shenguangmu/complete_project_source/skill/pitfalls/README.md

# 踩坑清单 —— 工具静默失败的定位方法

> **为什么这份清单值得读**：这些坑的共同特征是
> **工具不报错，或者报错位置离真正原因很远**。
> 每一条都给出**验证命令** —— 不靠推理，靠输出。

## 怎么用

按**现象**查，不按原因查。你手里只有现象。

| 现象 | 去哪条 |
|---|---|
| 综合/实现全过，但 DRC 报一堆莫名其妙的端口名 | **P1** |
| 加了"失败重试"，日志显示重试了但同一秒返回 | **P2** |
| 脚本跑到最后突然 `No open design`，产物缺失 | **P3** |
| OOC 综合日志里出现 `Failed to create directory 'C'` | **P4** |
| 改了源码，报告里的旧数字还在，没人发现 | **P5** |
| 测试脚本打了 `[FAIL]` 却报 `PASSED` | **P6** |
| 渲染/导出漏了一种块类型，内容静默消失 | **P7** |
| 综合通过但上板数据不对 | 见 `docs/board-bringup-guide.md` 的分级验证 |
| HLS 相关（pragma 被丢、csim 假成功…） | 见附录索引 |

---

## P1 · 顶层被静默设成子模块，整条流水线未进综合

**现象**

```
[DRC NSTD-1] 67 out of 67 logical ports use IOSTANDARD 'DEFAULT'
问题端口: cam_data[7:0], frame_cnt[15:0], aclk, pclk ...
```

端口名**看着像某个子模块的**，不是你的顶层。
日志里是 `Command: synth_design -top <子模块名>`。

**根因**

Block Design 生成时会**重新生成 wrapper**，把它从工程文件表里挤掉。
Vivado 只好在剩余模块里**自动挑一个当顶层** —— 挑中了某个 RTL 子模块。

**为什么难查**：**全流程静默通过**。综合、实现、出比特流都不报错。

**对策**

**必须回读断言**，不能靠"没报错就当对了"：

```tcl
set top_now [get_property top [current_fileset]]
if {$top_now ne "${BD_NAME}_wrapper"} {
    error "顶层设置失败：期望 ${BD_NAME}_wrapper，实际 '$top_now'"
}
if {[llength [get_files -quiet *${BD_NAME}_wrapper.v]] == 0} {
    error "wrapper 未登记进工程文件表"
}
```

**验证**

```bash
grep "Command: synth_design" <project>.runs/synth_1/runme.log
# 必须是你的顶层名。是子模块名 → 中招了
```

---

## P2 · `launch_runs` 对**已失败**的 run 不做任何事 → 重试是假的

**现象**

给 run 加了"失败就重跑"的重试，日志显示重试了，但**同一秒就返回**：

```
>>> synth_1 进度 0% —— 第 1 次未完成
>>> 重试...
[21:38:34] Waiting for synth_1 to finish...
[21:38:34] synth_1 finished        ← 同一秒返回，根本没跑
```

**根因**

`launch_runs` 认为那个 run "已经跑过了"（只是结果是失败），**于是什么都不做**。
光靠"再 launch 一次"是**假重试**。

**对策**

重试前先 `reset_run`（**已完成的子 run 不受影响**，只有失败的需要重跑）：

```tcl
if {$attempt > 1} { catch {reset_run -quiet $run_name} }
catch {launch_runs $run_name -jobs 8 {*}$launch_args}
catch {wait_on_run $run_name}
```

**⚠ 配套坑**：找失败子 run **不能用** `get_runs "${run_name}_*"` ——
run 叫 `synth_1`，子 run 却叫 `bd_video_dma_in_0_synth_1`，**glob 匹配不到**，
那段诊断会**静默失效**（你以为在报错，其实一行没输出）：

```tcl
# 错：匹配不到任何东西
foreach sr [get_runs -quiet "${run_name}_*"] { ... }

# 对：遍历全部，按后缀筛，排除父 run
foreach sr [get_runs] {
    set sn [get_property NAME $sr]
    if {$sn eq $run_name} { continue }
    if {[string match "*_$run_name" $sn] && [get_property PROGRESS $sr] ne "100%"} { ... }
}
```

> **这条的教训**：桩函数能验证"重试被调用了"，但**验证不了
> `launch_runs` 的真实语义**。控制流对 ≠ 行为对。

---

## P3 · `get_timing_paths` 需要**已打开的设计**

**现象**

脚本跑到 "实现完成" 后突然中断：

```
>>> 实现完成
ERROR: [Common 17-53] User Exception: No open design.
```

**后果**：后面的产物导出**根本没执行到**。
而 `write_bitstream completed successfully` 就在日志里 —— **容易误以为"都成功了"**。

**根因**

`get_timing_paths` 写在 `open_run impl_1` **之前**。

**对策**

```tcl
open_run impl_1        # ← 必须在前面

# 时序查询本身也加 catch —— 它只是**报告**，不该有中断整个流程的能力
if {[catch {
    set wns [get_property SLACK [get_timing_paths -delay_type max]]
    puts ">>> WNS = $wns ns"
} err]} {
    puts "WARN: 取时序失败（不影响产物）: $err"
}
```

**验证**

判据不是"脚本没报错"，而是**产物在不在**：

```bash
ls -la <project>/<name>.xsa <project>/utilization.rpt
```

> **这条的教训**：脚本"跑到最后一行"和"所有产物都生成了"是**两回事**。

---

## P4 · `Failed to create directory 'C'` —— 产物无害，**流程致命**

**现象**

OOC 综合日志里出现（**每次打中的 run 都不一样**，是随机的）：

```
ERROR: [Common 17-354] Could not open 'C' for writing.
ERROR: [Common 17-1257] Failed to create directory 'C'.
```

看起来像环境变量问题（某个变量为空、被展开成裸盘符 `C`），**但不是**。

**根因**

一次性启动 16–22 个 OOC 综合，每个 Vivado 实例都要建一批临时目录 ——
**并发建目录竞争的瞬时失败**。重跑必然成功
（中招的 run 自己的 `.dcp` 其实照样生成了）。

**已排除**（这些查过都不是原因）：
- `TEMP` / `TMP` 正常
- 无空环境变量会被展开成裸盘符
- 脚本里没有任何地方传过 `"C"`

**⚠ 为什么不能当噪声忽略**

Vivado 会把这个瞬时失败**判定成 run 失败**：

```
ERROR: [Vivado 12-13638] Failed runs(s) : '<run 名>'
ERROR: [Common 17-39] 'wait_on_runs' failed due to earlier errors.
```

于是 `wait_on_run` **直接抛错返回**，脚本中断 —— **后面的产物根本导不出来**。

**对策**：带 `reset_run` 的重试（见 **P2**）。

**验证**

```bash
grep -c "17-1257\|17-354" <run>/runme.log   # 出现了几条
grep -c "^ERROR" <impl>/runme.log            # 但整体 ERROR 应为 0
```

---

## P5 · 报告里的数字比源码旧 —— 改了代码，没人发现

**现象**：你改完源码、跑完综合、去读报告里的资源数，
**读到的是上一次运行的**。报告不会自己告诉你它过期了。

**本项目实际发生的**：
做 DSP 对照实验时来回改了四次源码，最后一次（展开版，86 DSP）跑完
就去写文档了；等回头核对数字时，`csynth.rpt` 里躺着的还是**85 实验版**的数，
而源码已经 `git checkout` 回基线了。
**如果当时没顺手多跑一次，写进报告的就是一组对不上源码的数字。**

**为什么危险**：这类错误的后果和 P2 一样 ——
**看起来一切正常**。数字是"真的"（确实是工具产出的），
只是**不是当前源码的**。csim 会拦住代码错误，**谁也拦不住这个**。

**验证命令**：

```bash
# ① 比时间戳：报告比源码旧，就说明报告过期了
ls -l --time-style=+%m-%d_%H:%M src_hls/gesture_preproc.cpp \
      gesture_comp/solution1/syn/report/csynth.rpt
#         源码必须比报告旧（或同一时刻）

# ② 比 git 状态：源码有未提交改动，报告必然对不上
git status --short src_hls/
```

**根治**：**不要在"源代码有未提交改动"的状态下引用报告数字**。
要么先 `git stash`/`checkout` 到目标状态重跑，要么在提交后重跑一次。

> **更一般的教训**：**引用一个数字前，先确认它属于哪次运行。**
> 这和"引用前先确认它属于哪个模块"（`WNS +0.265` 的教训）是同一类问题 ——
> 数字的**出处**和数字本身一样重要。

---

## P6 · 测试脚本打了 `[FAIL]` 却报 `PASSED`

**现象**：自检脚本明明打印了一行 `[FAIL] ...`，
最后汇总却是 `*** TEST PASSED ***`，退出码 0。CI 于是放行。

**根因**：失败路径**没有走计数器**。典型写法：

```python
def step2():
    try:
        from pynq import allocate
    except ImportError:
        print("    [FAIL] 连 pynq 都 import 不了")
        return False          # ← 打印了，但 _failed 没加一
```

主流程只在 `_failed` 里统计，而这个早退分支跳过了它 ——
**"报错"和"记账"是两条独立的路径，只做了前者。**

**本项目实际发生的**：写 `host/bringup_check.py` 时第一版就是这样，
在 PC 上试跑 `--step 2` 才抓到（无板环境必然 import 失败，正好走这条分支）。
**如果没有"无板也能跑一遍"这一步，这个 bug 会一直留到上板那天**，
而且表现是"明明失败却告诉你成功"—— 比直接崩掉危险得多。

**对策**：**所有失败路径都走同一个记账函数**，不允许裸 `return False`：

```python
def _fail():
    global _failed
    _failed += 1
    return False

# 所有早退分支统一写成
    print("    [FAIL] ...")
    return _fail()
```

**验证命令**（这条才是关键 —— 光看代码看不出来）：

```bash
# 故意制造一个必然失败的场景，看汇总结论对不对
python host/bringup_check.py --step 2   # 在无 pynq 的 PC 上跑
# 期望：打印 FAILED，且 echo $? == 1
```

> **一般化的教训**：**测试脚本本身也要被测。**
> 而且最省事的测法是**让它跑一个必然失败的场景** ——
> 正常路径谁都会测，**失败路径才是没人走的那条**。

---

## P7 · 渲染/导出漏了一种块类型，内容**静默消失**

**现象**：源文件里明明有的内容，生成出来的 Word / PDF / 静态站点里**没有**。
而且**不报任何错** —— 生成器照常打印"已完成"。

**根因**：生成器把源文件解析成若干**块类型**，
然后按类型分别渲染。**新加了一种块类型，却只在一个地方处理了它。**

**本项目实际发生的**（2026-09-19）：

给上板手册加"在哪跑"标记 `【终端：PC · Git Bash】`，
解析器产出了 `terminal` 块类型，但渲染器里那段处理写在了
`elif t == 'para'` 分支里 —— 而 `terminal` 是**独立类型**，走不到那一支。

结果：**17 个标记一个都没渲染出来，全被丢掉**。

更隐蔽的是**误导性的"部分成功"**：手册引言的代码块里正好有 4 行
**示例文字**也是 `【终端：…】` 的形状，它们作为代码内容被正常渲染了 ——
于是 grep 一下能搜到 4 个，看着像"功能是好的，只是少了几个"。

**怎么抓到的**：不是靠眼看，是靠一条**内容零丢失**的自动检查 ——
把源文件和产出的所有文字都摊平，反向核对每一行还在不在。
`scripts/test_manual.py` 第 [3] 项就是这个。

**对策**：

1. **加块类型时，把"渲染分支"和"测试的摊平函数"一起改。**
   本项目就被这个坑咬了两次：`iter_text()` 漏了 `terminal` 分支
   （导致测试误报"内容丢失"），`render()` 也漏了（真丢内容）。
2. **写一条"零丢失"检查**，别靠"生成成功"当判据。
   它抓的是**所有**静默丢失，不只是你想到的那一种。
3. ⚠ **两处渲染路径都要维护**：本项目有"主体渲染"和"引用块渲染"
   两条路径，只改一条 → 表现为"某些位置的标记不显示"，同样不报错。

> **一般化**：**生成器/编译器/导出器最危险的失败模式是"不报错、只少东西"。**
> 编译器至少有类型系统兜底，而**文档生成器什么都没有** ——
> 它丢一段和你故意删一段，产出是一样的。

---

## 附录：更完整的清单

本目录只列了**"工具流程全过、只有上板才暴露"**这一类中最典型的 7 条。
更完整的 15 条（HLS 接口/pragma、Vitis 命令行、BD/Tcl、Zynq 协同、环境噪声）
见项目仓库 `vivado/README.md` 的「踩过的 19 个坑」一节，
其中前 15 条按 A–E 五类组织。

**判断一条报错要不要管的通用方法**：

```bash
# 只看这两种级别
grep -E "ERROR|CRITICAL WARNING" <runme.log>
# 数一下
grep -c "^ERROR" <runme.log>
```

> 一个 33 KB 的 `vivado.log` 里有 **111 条 WARNING 但 0 条 ERROR** 是**正常**的。
> 别因为刷屏就以为工程有问题 —— 但也别反过来，把 ERROR 当噪声。
> **P4 就是后者**：它对产物无害，但对流程致命。
