shenguangmu/complete_project_source/location.png

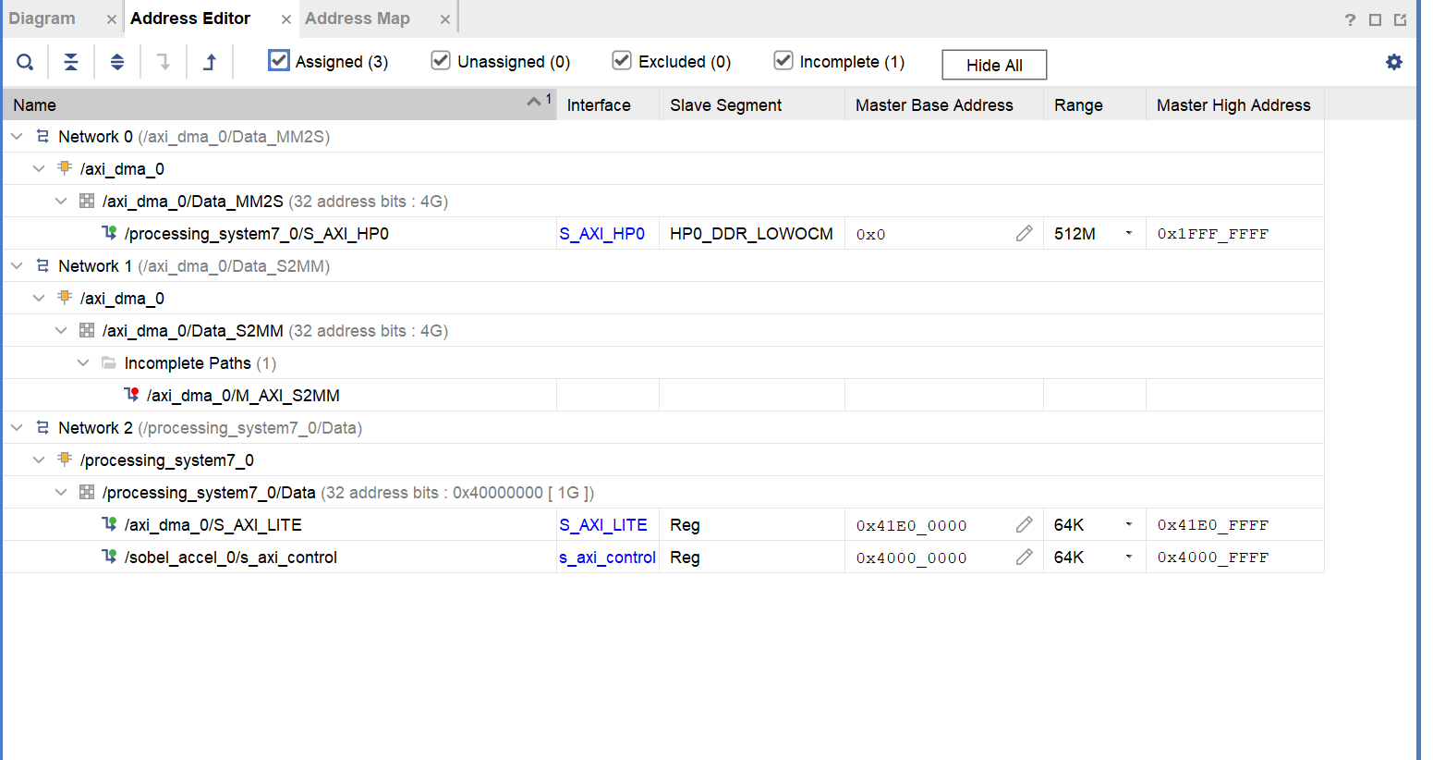
location.png
