shenguangmu/complete_project_source/docs/board-bringup-guide.md

# 上板测试指南 — 手势识别系统

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

---

### 本文用到的四个环境（**每段代码前都标了在哪跑**）

上板这件事最容易卡住的地方，不是命令本身，而是**不知道该在哪儿敲**。
所以本文在**每段代码前面**都加了一个标记：

```
【终端：PC · Git Bash】              ← 在你的开发机上
【终端：PYNQ · Jupyter 或串口】       ← 在板子上的 Linux 里
【终端：串口 · MobaXterm】            ← 串口终端（看启动日志用）
【终端：仪器 · 万用表】               ← 手持仪器，不是电脑
```

四个环境分别是：

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

> ⚠ **PC 和 PYNQ 上都有 Python，但装的东西完全不同**：
> PC 上**没有 `pynq` 模块**（`import pynq` 会失败，这是正常的）；
> PYNQ 上**没有 Vivado**。
> 在错的那一侧跑，报错是 `ModuleNotFoundError` 或 `command not found` ——
> 看着像环境坏了，其实只是跑错了地方。**这就是这些标记存在的理由。**

---

## 0. 先说结论：硬件已定，只剩 1 个阻塞

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

---

## 1. 前置条件（上电前必须确认的事项）

### 1.1 ~~B1~~ — 摄像头模块（**已定：PMOD-CAMERA v1.0** ✅）

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

**两个连接器的信号分配**：

```
J2 → Pmod A（6 根）： XMCLK / DVP_VSYNC / I2C_SDA / DVP_PCLK / DVP_HREF / I2C_SCL
                      （另有 2 个 NC 脚：ja[3]=Y17, ja[7]=W19）
J3 → Pmod B（8 根）： D6 D4 D2 D0 D7 D5 D3 D1  ← 数据线是**交错**的，不是顺序
```

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

---

### 1.2 ~~B2~~ — `io_xclk` 约束（**不缺** ✅）

> ## ⚠⚠ 更正：本指南初版这一节是错的
>
> **初版写的是"`io_xclk` 没有任何引脚约束，线是悬空的"—— 那是错的。**
>
> 实际约束在 `video_io.xdc:183`：
> ```tcl
> set_property -dict { PACKAGE_PIN Y18 IOSTANDARD LVCMOS33 } [get_ports io_xclk]
> ```
> **核实方式**（从实现产物回读，不是看文档）：
> ```
> $ grep io_xclk bd_video_wrapper_io_placed.rpt
> | Y18 | io_xclk | High Range | IO_L17P_T2_34 | OUTPUT | LVCMOS33 | ... | FIXED | ...
> ```
> `Constraint = FIXED` —— 约束确实生效了。
>
> **初版为什么错**：我把"某份规格表里没列 io_xclk"当成了"约束文件里没有它"，
> **没有做任何验证就写进了文档，还把它列成阻塞项**。
> 这正是本指南开头警告的那类错误 —— 只不过这次犯的是我自己。
>
> **教训**：判断"某个约束在不在"，要 `grep` 约束文件或回读实现报告，
> **不能凭印象或凭别的文档**。

既然用 PMOD-CAMERA（无晶振），`io_xclk` **必须保留**：

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

---

### 1.3 B3 — 寄存器表必须换成真的

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

`rtl/ov5640_regs.v` 曾经是**占位表**（`rtl/README.md` 当时写的：
"表里的 8 条寄存器值是猜测，**不足以让 OV5640 出图**"）。

TB 验的是**接口行为**（拼接顺序、位宽、边界），**不验内容** —— 所以 11/11 PASSED 不代表能用。

**症状**：万用表/示波器测得 `io_xclk` 有 24 MHz，但 **`io_pclk` 一直没波形**。
看到这个现象先查寄存器表，别去查 RTL。

**来源**：正点原子例程里的 `ov5640cfg.h`（或其 Linux 驱动 `ov5640.c`）。
需要的是「RGB565 / 640×480 / 30fps」那套配置。

> ⚠ **别只抄前几条**。OV5640 的配置是**有顺序依赖**的，
> 常见的是 `0x3103` 软复位 → `0x3008` 软复位 → 系统时钟 → 时序 →
> 输出格式 → 分辨率 → 才到具体画质寄存器。抄漏顺序会静默不出图。

---

### 1.4 ~~B4~~ — DDR 参数（**已修复并验证** ✅）

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

2026-09-17 已在 `bd_video.tcl` 补上三条并加了回读断言：

```tcl
CONFIG.PCW_UIPARAM_DDR_PARTNO    {MT41K256M16 RE-125}
CONFIG.PCW_UIPARAM_DDR_BUS_WIDTH {32 Bit}
CONFIG.PCW_UIPARAM_DDR_FREQ_MHZ  {533.333}
```

**2026-09-17 21:53 已重跑验证** ✅ —— 脚本输出：

```
>>> DDR 断言通过 (MT41K256M16 RE-125)
```

产物已更新（比特流 + XSA 里都是正确配置）。**这一条不再是阻塞项。**

> 将来若重建工程，判定标准仍然是日志里出现 `>>> DDR 断言通过 (MT41K256M16 RE-125)`。
> **没有这一行就是没生效**，别继续。

---

## 2. 不接电的安全检查

### 2.1 短路检查

万用表**电阻档（或蜂鸣档）**，测 **3V3 对 GND**：

| 读数 | 含义 |
|---|---|
| 呜一声 / < 10 Ω | **短路，绝对不要上电** |
| 几百 Ω 以上 / 逐渐上升 | 正常（电容充电） |

对**摄像头模块**单独测一次，再对**插上之后的板子**测一次。

### 2.2 引脚万用表复核（**烧板风险，不能跳**）

**【未验证】** XDC 的引脚映射是推理的，没实测过。

**只用量电平和通断，不用示波器，也不需要上电**：
【终端：仪器 · 万用表（通断档）】

```
① 万用表 → 通断档
② 表笔黑端接 PYNQ-Z2 的 GND（挑一个板上标了 GND 的排针）
③ 表笔红端逐个点 Pmod A 的 8 个物理针
④ 通的那个就是 GND 列 —— 记下来
⑤ 同样方法找 3V3（接 3.3V 排针）
⑥ 对照 video_io.xdc 末尾的预期表，核对 GND/3V3 是否落在同一列
```

**判定**：如果 GND/3V3 的位置和 `video_io.xdc` 里推的不一致，
**立刻停止，回来改 XDC**，不要"先插上试试"。

> 这一步花 5 分钟，省掉一块板子。

---

## 3. 上电与 PS 侧验证（**先不加载比特流**）

### 3.1 上电顺序
【终端：硬件 · 断电状态下插线，最后才上电】

```
① 插好 SD 卡（PYNQ 镜像，v3.0.1）
② 接串口线（Micro USB，板上标 UART）
③ 打开串口终端（115200 8N1）
④ 最后插 12V 电源
```

**串口终端选哪个** —— 推荐 **MobaXterm（家庭版，免费）**：

| 工具 | 评价 |
|---|---|
| **MobaXterm Home Edition** ✅ **首选** | **串口 + SSH + SFTP 三合一**，而且免费、有免安装便携版。<br>本项目后面要做的三件事它一个顶三个：<br>· **串口**看 PYNQ 启动日志（`Session → Serial`，选 COM 口 + 115200）<br>· **SSH** 登板子跑命令（串口只能看，敲长命令不方便）<br>· **SFTP 拖拽**传 `.bit` / `.hwh`（省掉记 `scp` 命令） |
| PuTTY | 够用且极小，但**只有串口/SSH，没有文件传输** ——<br>传 `.bit` 还得另找 WinSCP。只当串口终端可以 |
| `tio` / `picocom` | Linux/macOS 上的命令行串口工具，简洁可靠。<br>本机是 Windows，用不上 |
| 各类"串口助手"小工具 | ⚠ 只收发热门波特率的能用，但**看不到 Linux 启动全过程的滚屏**，<br>排查"卡在 Loading kernel"时很吃亏 |

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

### 3.2 光一个指示灯就能砍掉一半问题

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

> 这一步就能验证 B4。**DDR 错了，Linux 根本起不来。**

### 3.3 进 PYNQ
【终端：串口 · MobaXterm（或 PuTTY）· 115200 8N1】

```bash
# 串口里
login: xilinx
password: xilinx

# 看网口 IP（PC 与板子同网段）
ifconfig
```

浏览器开 `http://<板子IP>:9090` → Jupyter。或者直接用串口跑 Python。

---

## 4. 加载 overlay

### 4.0 先把两个文件弄出来（**XSA 里就有，不用重新跑**）

PYNQ 要的是 **`.bit` + `.hwh` 两个文件**，它们**都在仓库里的 `gesture_system.xsa` 中** ——
`.xsa` 本质是个 zip，直接解压即可，**不需要重跑综合**：
【终端：PC · Git Bash】

```bash
# 在 PC 上，仓库根目录
cd vivado/gesture_system
unzip -o gesture_system.xsa -d /tmp/xsa_extract

# 看看里面有什么
unzip -l gesture_system.xsa | grep -E "\.bit|\.hwh"
#   bd_video.hwh            744,025 B
#   gesture_system.bit    4,045,692 B     ← 与 build-report 记录的字节数一致，可据此核对
```

> ⚠ **`.hwh` 在 xsa 里叫 `bd_video.hwh`，但必须改名成 `gesture_system.hwh`** ——
> PYNQ 靠**同名**配对找 IP 表：`gesture_system.bit` ⟷ `gesture_system.hwh`。
> 名字不一致时 PYNQ 不会报"找不到 hwh"，而是**只认出 `default` 一个 IP**，
> 然后你在 `ip_dict` 里一个我们的 IP 都看不到 —— 很容易误判成 overlay 有问题。
【终端：PC · Git Bash】

```bash
# 传到板子（改成同名同目录）
scp gesture_system.bit  xilinx@<板子IP>:/home/xilinx/
scp /tmp/xsa_extract/bd_video.hwh xilinx@<板子IP>:/home/xilinx/gesture_system.hwh
```

**核对拿对了没有**：

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

**两个文件必须同名同目录**（PYNQ 靠配对的 `.hwh` 解析 IP 表）。
【终端：PYNQ · Jupyter（浏览器 :9090）或串口】

```python
from pynq import Overlay
ol = Overlay("/home/xilinx/gesture_system.bit")

# ⚠ 先看它到底认出了什么，别猜
print(sorted(ol.ip_dict.keys()))
```

**期望看到**（**【已核实】** 来自 `bd_video.hwh`）：

```
vdma, v_tc, dma_in, dma_out, gesture_preproc_0
```

**立刻记下地址**（后面每一步都要用）：

```python
for n in ["vdma", "v_tc", "dma_in", "dma_out", "gesture_preproc_0"]:
    ip = ol.ip_dict.get(n)
    print(f"{n:20s} {ip}")
```

**【已核实】** `.hwh` 里的地址是这个（**不是** `docs/architecture-contract.md` §2.14 写的 `0x4300_0000`/`0x43C0_0000`，那是原 Sobel 工程的残留）：

| IP | BASE |
|---|---|
| `gesture_preproc_0` | `0x4000_0000` |
| `dma_in` | `0x41E0_0000` |
| `dma_out` | `0x41E1_0000` |
| `v_tc` | `0x44A0_0000` |
| `vdma` | `0x44A1_0000` |

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

**版本警告**：PYNQ 镜像与 Vivado 2025.2 的兼容性**【未验证】**。
报版本错时：

```python
ol = Overlay("gesture_system.bit", ignore_version=True)
```

---

## 5. 验证顺序（**这是全文最重要的一节**）

按顺序走。**每一步失败就停下**，不要跳过去试下一步 ——
后面所有现象都会被前面没验证的环节污染。

```
① 加载 overlay，ip_dict 认全           → 本文 §4
② DDR 能分配 buffer，读写一致           → 本文 §5.1      ← 不需要摄像头
③ 只跑预处理链（不碰摄像头）            → 本文 §5.2      ← 不需要摄像头
④ io_xclk 有 24 MHz                    → 本文 §5.3
⑤ io_scl 有脉冲（SCCB 在跑）            → 本文 §5.3
⑥ io_pclk 有波形（摄像头配置成功）      → 本文 §5.3
⑦ io_href / io_vsync 有脉冲             → 本文 §5.3
⑧ 数据线 io_d 不是恒 0                  → 本文 §5.3
⑨ VDMA 能抓到帧                        → 本文 §5.4   ← 依赖 ⑥⑦⑧
⑩ 全链路：摄像头 → 96×96               → 本文 §5.5   ← 依赖 ⑨+③
```

**②③ 不需要摄像头**，所以**摄像头还没到货也能先做掉** —— 现在就可以做。

> ### ✅ ②③ 已脚本化：`host/bringup_check.py`
>
> 上面 ②③ 两步的代码**不用手敲**了 —— 已做成可直接跑的脚本：
>
> ```bash
> python3 host/bringup_check.py            # 跑 ②③
> python3 host/bringup_check.py --step 2   # 只跑 DDR 自检
> python3 host/bringup_check.py --json r.json   # 结果落盘（报告用）
> ```
>
> 判定：`*** BRINGUP CHECK PASSED ***`。
> 它会在每一步给出**针对性的排查提示**（比如输出全黑时列出三个常见原因）。
>
> ⚠ **④~⑧ 需要示波器/逻辑分析仪，脚本不做** ——
> 那些是模拟信号的逐级排查，没法自动化。
> 但 ②③ 脚本化之后，**摄像头插上时只剩一条线要查**。

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

| 写在哪 | 指的是 |
|---|---|
| §1.1 表格「出处」列 | `hardware-checklist.md` 第三章、`architecture-contract.md` 第二章 |
| §4 表格上方的注 | `architecture-contract.md` §2.14（那里写的地址**已过时**，勿用） |
| §4 引用契约 | `architecture-contract.md` §3.1 |
| §5.2 启动顺序 | `docs/architecture-contract.md` §4.3 |
| §5.3 上方 | `docs/hardware-checklist.md` 第二章（工具采购建议） |
| §6.1 表格「出处」列 | skill `09-pitfalls.md` 的 C1/C3/E1、`gui-reproduction-guide.md` §2.9 |

---

### 5.1 DDR 与 buffer 基本自检
【终端：PYNQ · Jupyter 或串口】

```python
from pynq import allocate
import numpy as np

buf = allocate(shape=(9216,), dtype=np.uint8)
buf[:] = np.arange(9216, dtype=np.uint8)
print("读回一致:", np.array_equal(buf, np.arange(9216, dtype=np.uint8)))
print("物理地址:", hex(buf.physical_address))
```

**判定**：打印 `True` 且有非 0 物理地址。
**失败** → 回 §1.4，DDR 参数不对。

---

### 5.2 第一步真正的功能验证：**只跑预处理链**（不需要摄像头）

这是**当前最应该先做的事** —— 它把摄像头这个最大的不确定性排除在外。

数据流：

```
DDR(输入 640×480 RGB565) ─► dma_in(MM2S) ─► gesture_preproc ─► dma_out(S2MM) ─► DDR(96×96)
```

**⚠ 启动顺序不能反**（`docs/architecture-contract.md` §4.3）：

```
① 填输入数据 + flush cache
② 先武装 dma_out（S2MM）   ← 必须先，否则预处理输出的第一拍没有接收方
③ 再启动 dma_in（MM2S）
④ 最后 ap_start
⑤ 轮询 ap_done
⑥ invalidate cache，读结果
```
【终端：PYNQ · Jupyter 或串口】

```python
inbuf  = allocate(shape=(640*480,), dtype=np.uint16)   # RGB565
outbuf = allocate(shape=(9216,), dtype=np.uint8)       # 96×96

# 用 host/dump_frame.py 造的测试图当输入，或先填个已知图案
# ... 填 inbuf ...

inbuf.flush()
outbuf.flush()

# ⚠ 顺序：先 S2MM，再 MM2S
dma_out.recvchannel.transfer(outbuf)
dma_in.sendchannel.transfer(inbuf)

gp = ol.gesture_preproc_0
gp.write(0x00, 0x01)          # ⚠ AP_START 在 0x00，不是 0x04

while not (gp.read(0x00) >> 1) & 1:   # ⚠ bit1 = AP_DONE，也在 0x00
    pass

outbuf.invalidate()
```

> ### ⚠⚠ 状态位在 `0x00`，不在 `0x04`
>
> 这是本项目**踩过的大坑**（skill `09-pitfalls.md` D2）：
> HLS 生成的寄存器里**根本没有名为 STATUS 的寄存器**。
>
> | 偏移 | 名称 | 作用 |
> |---|---|---|
> | `0x00` | **CTRL** | 控制 + **状态位就在这里** |
> | `0x04` | GIER | 全局中断使能 —— **不是状态！** |
> | `0x08` | IP_IER | 通道中断使能 |
> | `0x0C` | IP_ISR | 通道中断状态 |
>
> `CTRL` 位域：`bit0=AP_START`(RW) · `bit1=AP_DONE`(RO) · `bit2=AP_IDLE`(RO) · `bit3=AP_READY`(RO)
>
> **别自己给寄存器起名。** 从 `.hwh` 提取真实偏移：
> ```bash
> python <skill>/pynq/ip_contract.py gesture_system.hwh --ip gesture_preproc_0
> ```

**判定**：`outbuf` 里的值和 PC 上 golden 对得上。
【终端：PC · Git Bash】

```bash
# PC 侧
python host/dump_frame.py stats board.bin
python host/dump_frame.py compare board.bin golden.bin
python host/dump_frame.py show board.bin --png out.png
```

**这一步跑通，说明 PL 的预处理链 + 两次 DMA + DDR 通路全部正常。**
后面摄像头出问题就一定能定位在采集侧。

---

### 5.3 摄像头信号逐级排查（**有了示波器/逻辑分析仪再做**）

> ⚠ 没有示波器或逻辑分析仪的话，这一节做不了。
> `docs/hardware-checklist.md` §二自己写了：
> "没有它，只能靠猜和改代码，调试周期会从半天变成一周"。
> **这是本项目最值得买的一个 ¥40 工具。**

按顺序量，**每一级失败都给出确定的结论**：

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

---

### 5.4 VDMA 抓帧

**前提**：§5.3 的 ⑥⑦⑧ 都通过（有 PCLK/HREF/VSYNC 和有效数据）。

VDMA 是 **3 帧缓存**（`c_num_fstores=3`），地址不硬编码：
【终端：PYNQ · Jupyter 或串口】

```python
vdma = ol.vdma
# 地址从 hwh/ip_dict 读，不要写死 0x44A10000
```

**判定**：把 DDR 里 VDMA 写的帧 dump 出来，用 `dump_frame.py show` 看到**摄像头画面**
（不是全黑、不是噪声）。

---

### 5.5 全链路

§5.4 通过 + §5.2 通过 → 直接跑 `host/gesture_overlay.py`：
【终端：PYNQ · Jupyter 或串口】

```python
from gesture_overlay import GesturePipeline
g = GesturePipeline()
g.print_info()          # 先看 IP 认出来没有
g.setup_dma()
g.config()
g.fill_test_pattern()   # 无摄像头时验数据通路
g.run_once()
g.show()                # Jupyter 里出图
```

结果与 PC golden 对拍：
【终端：PC · Git Bash】

```bash
python host/dump_frame.py stats board.bin
python host/dump_frame.py compare board.bin golden.bin
```

**数据格式**：裸 `.bin` 无头，`uint8`，行优先，96×96 = **9216 字节**。

> `stats` 子命令会打 **4×4 分块均值** —— 这一项能区分
> "整体偏移"和"只有一块有内容（**ROI 位置问题**）"。

---

## 6. 已知会误导你的现象（**读这一节省几小时**）

### 6.1 工具流程全过，不代表能用

本项目的记录里，**至少三类问题在综合/实现/比特流阶段全都静默通过**：

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

**所以**：不要用"工具跑通了"当作通过标准。用 §5 的分级验证。

### 6.2 两条容易误判的报错

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

### 6.3 `runme.bat` / `runme.sh` 改了没用

它们是 Vivado 每个 run **每次重新生成**的。想改 run 行为要用
`config_*` 参数或 pre-hook，改这两个文件下次就被覆盖。

### 6.4 想复用旧工程目录时

`create_project.tcl` 默认**删掉整个工程目录重建**。
如果 GUI 里改过东西、不想被抹掉，加 `--keep`：
【终端：PC · Git Bash】

```bash
vivado -mode batch -source create_project.tcl -tclargs --keep
```

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

---

## 7. 附：本次排查留下的技术结论

### 7.1 `Common 17-1257 / 17-354` —— 对产物无害，**对流程致命**

**【已核实】** 只出现在两个 IP 的 OOC 综合日志，且都在**同一次启动的同一时刻**：

```
runme.log:15  ERROR: [Common 17-1257] Failed to create directory 'C'.
runme.log:16  source bd_video_dma_in_0.tcl -notrace        ← 它跑到这，没退出
runme.log:17  create_project: Time (s): cpu = 00:00:11     ← 正常返回
```

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

**原因**：一次性启动 16–22 个 OOC 综合，每个 Vivado 实例都要建一批临时目录——
**并发建目录竞争 / 杀软-文件索引拦截**的瞬时失败。重跑即成功。

**已排除**：`TEMP`/`TMP` 正常（`(系统临时目录)`）；
没有空环境变量会被展开成裸盘符；工程脚本里没有任何地方传过 `"C"`。

#### ⚠⚠ 更正（2026-09-17，实测推翻初版结论）

**初版本指南写的是"100% 无害，直接忽略"—— 那是错的。**

它对**产物**无害，但对**流程致命**：

```
ERROR: [Vivado 12-13638] Failed runs(s) : 'bd_video_ic_ctrl_imp_xbar_0_synth_1'
ERROR: [Common 17-39] 'wait_on_runs' failed due to earlier errors.   ← 脚本在此中断
```

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

**初版为什么误判**：当时的依据是"产物齐全 + 返回码 0"，
**没有考虑它对上层批处理流程的影响**。
教训：一个错误"是不是无害"，要看**谁在消费它的后果**，不能只看直接产物。

**现在的处理**（`create_project.tcl` 里）：

```tcl
proc run_with_retry {run_name launch_args {max_attempts 3}} {
    for {set attempt 1} {$attempt <= $max_attempts} {incr attempt} {
        if {$attempt > 1} { catch {reset_run -quiet $run_name} }   ;# ← 关键
        catch {launch_runs $run_name -jobs 8 {*}$launch_args}
        catch {wait_on_run $run_name}
        ...
    }
}
```

⚠ **`reset_run` 是必需的，漏了就变成"假重试"**：
`launch_runs` 对**已经失败的 run 不做任何事**（它认为"跑过了"）。
实测日志：

```
>>> synth_1 进度 0% —— 第 1 次未完成
>>> 重试...
[21:38:34] Waiting for synth_1 to finish...
[21:38:34] synth_1 finished        ← 同一秒返回，根本没跑
>>> synth_1 进度 0% —— 第 2 次未完成
```

先 `reset_run` 清掉失败状态，`launch_runs` 才会真正执行。
（已完成的子 run 不受影响，只有失败的需要重跑。）

---

### 7.2 `Netlist 29-160` —— 无害，但掩盖了一个真问题

**【已核实】**

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

### 7.3 已完成的修改（2026-09-17）

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

> ⚠ 两处修改都**只改了脚本**。**现有比特流（2026-09-16 21:25）里是旧配置**，
> 必须按 §1.4 重跑才能生效。

---

## 8. 待验证清单（按"说清楚什么没验证"的原则）

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

---

## 9. 一页速查
【终端：PC · Git Bash】

```bash
# ---- 建工程 + 出比特流（改了 bd_video.tcl 之后必须重跑）----
cd <仓库根>/vivado
vivado -mode batch -source create_project.tcl
#   只看 DDR 断言过没过：
#     >>> DDR 断言通过 (MT41K256M16 RE-125)

# ---- 只检查 BD 是否合法（约 1 分钟，不跑综合）----
vivado -mode batch -source create_project.tcl -tclargs --synth 0

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

# ---- PC 侧数据处理 ----
python host/dump_frame.py stats board.bin
python host/dump_frame.py compare board.bin golden.bin
python host/dump_frame.py show board.bin --side-by-side golden.bin --png cmp.png
```
【终端：PYNQ · Jupyter 或串口】

```python
# ---- 板上 PYNQ ----
from pynq import Overlay, allocate
ol = Overlay("gesture_system.bit", ignore_version=True)
print(sorted(ol.ip_dict.keys()))
# 期望：vdma, v_tc, dma_in, dma_out, gesture_preproc_0
```

**验证顺序一句话**：

```
先跑 §5.2（预处理链，不要摄像头）→ 通了再碰摄像头
摄像头按 io_xclk → io_scl → io_pclk → HREF/VSYNC → 数据 逐级量
```

**三个"看到就停"的信号**：

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

---

## 10. 打印版（Word 操作手册）

本文还有一份**排版好的 Word 版**，适合打印出来带到工位上：
【终端：PC · Git Bash（或直接看仓库里的文件）】

```
docs/上板测试操作手册.docx
```

**它是从本文自动生成的，不是手工维护的第二份。**
改了本文件之后重跑一次即可：
【终端：PC · Git Bash】

```bash
python scripts/build_manual.py      # 生成 docx
python scripts/test_manual.py       # 校验没有内容在渲染中丢失
```

> ⚠ **不要直接改 Word**。Word 版是渲染产物，
> 手工改的内容下次重新生成就没了，而且两份会开始分叉 ——
> 这个项目已经在"双目录分叉"上吃过一次亏。
> **要改内容就改本文件（`.md`），它是唯一事实来源。**

Word 版针对打印做的处理：

| 项 | 说明 |
|---|---|
| 版面 | A4、页边距 2cm、正文 10.5pt |
| 分页 | **每个二级标题另起一页** —— 手上拿一张做一个阶段 |
| 代码块 | 等宽 + 灰底 + 左边框（终端命令抄错一个字符就白跑一轮） |
| 引用块 | 左边框高亮（本手册的"⚠ 注意"全在引用块里） |
| 页眉页脚 | 文档名 + 第 X 页 / 共 Y 页 |
| **手填记录表** | 万用表读数、示波器频率这类**当场要记的数**，<br>每个相关小节末尾都有一张空白表 |

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
