shenguangmu/complete_project_source/rtl/ov5640_regs.v

// =====================================================================
//  ov5640_regs.v —— OV5640 寄存器配置 ROM（640x480 RGB565）
//
//  ⚠ 本文件由脚本生成，不要手工编辑。
//
//  ─────────────────────────────────────────────────────────────────
//  数据来源
//  ─────────────────────────────────────────────────────────────────
//  正点原子官方例程 i2c_ov5640_rgb565_cfg.v（250 条，RGB565）
//    prepare/paulgeorge66_2025/src/morphilogical/rtl/
//
//  该表原设计为**动态分辨率**：0x3808~0x380f 由 cmos_h/v_pixel、
//  total_h/v_pixel 四个参数代入。本文件把它们固化为 640x480 常量。
//
//  固化值的依据：**FPGA-ANLU-National-First-Prize** 项目用的是
//  同一份表文件（ROM 条目逐条 diff 完全相同），但它跑 640x480：
//      H_CMOS_DISP = 640,  V_CMOS_DISP = 480
//      TOTAL_H_PIXEL = H + 1216 = 1856
//      TOTAL_V_PIXEL = V + 504  = 984
//  得到 0x3808=0x0280 0x380a=0x01E0 0x380c=0x0740 0x380e=0x03D8。
//
//  ─────────────────────────────────────────────────────────────────
//  ⚠⚠ 改了表必须同步改的地方（否则 sccb 配到一半就停）
//  ─────────────────────────────────────────────────────────────────
//    * 本文件 N_REGS = 250
//    * **BD 里 sccb_0 的 N_REGS —— 必须同为 250**
//      sccb_master.v 里的默认值是 64，不改会只配前 64 条就停。
//
//  ─────────────────────────────────────────────────────────────────
//  仍未验证的部分（如实记录）
//  ─────────────────────────────────────────────────────────────────
//  * **本表未上板实测。** 验证方式：上电后 io_scl 有波形，
//    且 io_pclk 出现波形（说明 SCCB 配置成功、摄像头开始出图）。
//  * 输出格式已由 0x4300=0x61 指定为 RGB565，0x503d=0x00 关闭彩条。
//  * 0x3814/0x3815 = 0x31（无子采样），即 1:1 输出 640x480，不缩放。
// =====================================================================

`timescale 1ns / 1ps

module ov5640_regs #(
    // ⚠ 改这里必须同步改 BD 里 sccb_0 的 N_REGS
    parameter N_REGS = 250,
    // 地址位宽，必须与 sccb_master 的 tbl_addr 一致（都是 8 位）
    parameter ADDR_W = 8
) (
    input  wire [ADDR_W-1:0] tbl_addr,
    output wire [23:0]       tbl_data
);

    reg [23:0] rom [0:N_REGS-1];

    initial begin
        rom[  0] = 24'h300A_00;
        rom[  1] = 24'h300B_00;
        rom[  2] = 24'h3008_82;
        rom[  3] = 24'h3008_02;
        rom[  4] = 24'h3103_02;
        rom[  5] = 24'h3017_FF;
        rom[  6] = 24'h3018_FF;
        rom[  7] = 24'h3037_13;
        rom[  8] = 24'h3108_01;
        rom[  9] = 24'h3630_36;
        rom[ 10] = 24'h3631_0E;
        rom[ 11] = 24'h3632_E2;
        rom[ 12] = 24'h3633_12;
        rom[ 13] = 24'h3621_E0;
        rom[ 14] = 24'h3704_A0;
        rom[ 15] = 24'h3703_5A;
        rom[ 16] = 24'h3715_78;
        rom[ 17] = 24'h3717_01;
        rom[ 18] = 24'h370B_60;
        rom[ 19] = 24'h3705_1A;
        rom[ 20] = 24'h3905_02;
        rom[ 21] = 24'h3906_10;
        rom[ 22] = 24'h3901_0A;
        rom[ 23] = 24'h3731_12;
        rom[ 24] = 24'h3600_08;
        rom[ 25] = 24'h3601_33;
        rom[ 26] = 24'h302D_60;
        rom[ 27] = 24'h3620_52;
        rom[ 28] = 24'h371B_20;
        rom[ 29] = 24'h471C_50;
        rom[ 30] = 24'h3A13_43;
        rom[ 31] = 24'h3A18_00;
        rom[ 32] = 24'h3A19_F8;
        rom[ 33] = 24'h3635_13;
        rom[ 34] = 24'h3636_03;
        rom[ 35] = 24'h3634_40;
        rom[ 36] = 24'h3622_01;
        rom[ 37] = 24'h3C01_34;
        rom[ 38] = 24'h3C04_28;
        rom[ 39] = 24'h3C05_98;
        rom[ 40] = 24'h3C06_00;
        rom[ 41] = 24'h3C07_08;
        rom[ 42] = 24'h3C08_00;
        rom[ 43] = 24'h3C09_1C;
        rom[ 44] = 24'h3C0A_9C;
        rom[ 45] = 24'h3C0B_40;
        rom[ 46] = 24'h3810_00;
        rom[ 47] = 24'h3811_10;
        rom[ 48] = 24'h3812_00;
        rom[ 49] = 24'h3708_64;
        rom[ 50] = 24'h4001_02;
        rom[ 51] = 24'h4005_1A;
        rom[ 52] = 24'h3000_00;
        rom[ 53] = 24'h3004_FF;
        rom[ 54] = 24'h4300_61;
        rom[ 55] = 24'h501F_01;
        rom[ 56] = 24'h440E_00;
        rom[ 57] = 24'h5000_A7;
        rom[ 58] = 24'h3A0F_30;
        rom[ 59] = 24'h3A10_28;
        rom[ 60] = 24'h3A1B_30;
        rom[ 61] = 24'h3A1E_26;
        rom[ 62] = 24'h3A11_60;
        rom[ 63] = 24'h3A1F_14;
        rom[ 64] = 24'h5800_23;
        rom[ 65] = 24'h5801_14;
        rom[ 66] = 24'h5802_0F;
        rom[ 67] = 24'h5803_0F;
        rom[ 68] = 24'h5804_12;
        rom[ 69] = 24'h5805_26;
        rom[ 70] = 24'h5806_0C;
        rom[ 71] = 24'h5807_08;
        rom[ 72] = 24'h5808_05;
        rom[ 73] = 24'h5809_05;
        rom[ 74] = 24'h580A_08;
        rom[ 75] = 24'h580B_0D;
        rom[ 76] = 24'h580C_08;
        rom[ 77] = 24'h580D_03;
        rom[ 78] = 24'h580E_00;
        rom[ 79] = 24'h580F_00;
        rom[ 80] = 24'h5810_03;
        rom[ 81] = 24'h5811_09;
        rom[ 82] = 24'h5812_07;
        rom[ 83] = 24'h5813_03;
        rom[ 84] = 24'h5814_00;
        rom[ 85] = 24'h5815_01;
        rom[ 86] = 24'h5816_03;
        rom[ 87] = 24'h5817_08;
        rom[ 88] = 24'h5818_0D;
        rom[ 89] = 24'h5819_08;
        rom[ 90] = 24'h581A_05;
        rom[ 91] = 24'h581B_06;
        rom[ 92] = 24'h581C_08;
        rom[ 93] = 24'h581D_0E;
        rom[ 94] = 24'h581E_29;
        rom[ 95] = 24'h581F_17;
        rom[ 96] = 24'h5820_11;
        rom[ 97] = 24'h5821_11;
        rom[ 98] = 24'h5822_15;
        rom[ 99] = 24'h5823_28;
        rom[100] = 24'h5824_46;
        rom[101] = 24'h5825_26;
        rom[102] = 24'h5826_08;
        rom[103] = 24'h5827_26;
        rom[104] = 24'h5828_64;
        rom[105] = 24'h5829_26;
        rom[106] = 24'h582A_24;
        rom[107] = 24'h582B_22;
        rom[108] = 24'h582C_24;
        rom[109] = 24'h582D_24;
        rom[110] = 24'h582E_06;
        rom[111] = 24'h582F_22;
        rom[112] = 24'h5830_40;
        rom[113] = 24'h5831_42;
        rom[114] = 24'h5832_24;
        rom[115] = 24'h5833_26;
        rom[116] = 24'h5834_24;
        rom[117] = 24'h5835_22;
        rom[118] = 24'h5836_22;
        rom[119] = 24'h5837_26;
        rom[120] = 24'h5838_44;
        rom[121] = 24'h5839_24;
        rom[122] = 24'h583A_26;
        rom[123] = 24'h583B_28;
        rom[124] = 24'h583C_42;
        rom[125] = 24'h583D_CE;
        rom[126] = 24'h5180_FF;
        rom[127] = 24'h5181_F2;
        rom[128] = 24'h5182_00;
        rom[129] = 24'h5183_14;
        rom[130] = 24'h5184_25;
        rom[131] = 24'h5185_24;
        rom[132] = 24'h5186_09;
        rom[133] = 24'h5187_09;
        rom[134] = 24'h5188_09;
        rom[135] = 24'h5189_75;
        rom[136] = 24'h518A_54;
        rom[137] = 24'h518B_E0;
        rom[138] = 24'h518C_B2;
        rom[139] = 24'h518D_42;
        rom[140] = 24'h518E_3D;
        rom[141] = 24'h518F_56;
        rom[142] = 24'h5190_46;
        rom[143] = 24'h5191_F8;
        rom[144] = 24'h5192_04;
        rom[145] = 24'h5193_70;
        rom[146] = 24'h5194_F0;
        rom[147] = 24'h5195_F0;
        rom[148] = 24'h5196_03;
        rom[149] = 24'h5197_01;
        rom[150] = 24'h5198_04;
        rom[151] = 24'h5199_12;
        rom[152] = 24'h519A_04;
        rom[153] = 24'h519B_00;
        rom[154] = 24'h519C_06;
        rom[155] = 24'h519D_82;
        rom[156] = 24'h519E_38;
        rom[157] = 24'h5480_01;
        rom[158] = 24'h5481_08;
        rom[159] = 24'h5482_14;
        rom[160] = 24'h5483_28;
        rom[161] = 24'h5484_51;
        rom[162] = 24'h5485_65;
        rom[163] = 24'h5486_71;
        rom[164] = 24'h5487_7D;
        rom[165] = 24'h5488_87;
        rom[166] = 24'h5489_91;
        rom[167] = 24'h548A_9A;
        rom[168] = 24'h548B_AA;
        rom[169] = 24'h548C_B8;
        rom[170] = 24'h548D_CD;
        rom[171] = 24'h548E_DD;
        rom[172] = 24'h548F_EA;
        rom[173] = 24'h5490_1D;
        rom[174] = 24'h5381_1E;
        rom[175] = 24'h5382_5B;
        rom[176] = 24'h5383_08;
        rom[177] = 24'h5384_0A;
        rom[178] = 24'h5385_7E;
        rom[179] = 24'h5386_88;
        rom[180] = 24'h5387_7C;
        rom[181] = 24'h5388_6C;
        rom[182] = 24'h5389_10;
        rom[183] = 24'h538A_01;
        rom[184] = 24'h538B_98;
        rom[185] = 24'h5580_06;
        rom[186] = 24'h5583_40;
        rom[187] = 24'h5584_10;
        rom[188] = 24'h5589_10;
        rom[189] = 24'h558A_00;
        rom[190] = 24'h558B_F8;
        rom[191] = 24'h501D_40;
        rom[192] = 24'h5300_08;
        rom[193] = 24'h5301_30;
        rom[194] = 24'h5302_10;
        rom[195] = 24'h5303_00;
        rom[196] = 24'h5304_08;
        rom[197] = 24'h5305_30;
        rom[198] = 24'h5306_08;
        rom[199] = 24'h5307_16;
        rom[200] = 24'h5309_08;
        rom[201] = 24'h530A_30;
        rom[202] = 24'h530B_04;
        rom[203] = 24'h530C_06;
        rom[204] = 24'h5025_00;
        rom[205] = 24'h3035_11;
        rom[206] = 24'h3036_3C;
        rom[207] = 24'h3C07_08;
        rom[208] = 24'h3820_46;
        rom[209] = 24'h3821_01;
        rom[210] = 24'h3814_31;
        rom[211] = 24'h3815_31;
        rom[212] = 24'h3800_00;
        rom[213] = 24'h3801_00;
        rom[214] = 24'h3802_00;
        rom[215] = 24'h3803_04;
        rom[216] = 24'h3804_0A;
        rom[217] = 24'h3805_3F;
        rom[218] = 24'h3806_07;
        rom[219] = 24'h3807_9B;
        rom[220] = 24'h3808_02;   // ← 640x480 固化值
        rom[221] = 24'h3809_80;   // ← 640x480 固化值
        rom[222] = 24'h380A_01;   // ← 640x480 固化值
        rom[223] = 24'h380B_E0;   // ← 640x480 固化值
        rom[224] = 24'h380C_07;   // ← 640x480 固化值
        rom[225] = 24'h380D_40;   // ← 640x480 固化值
        rom[226] = 24'h380E_03;   // ← 640x480 固化值
        rom[227] = 24'h380F_D8;   // ← 640x480 固化值
        rom[228] = 24'h3813_06;
        rom[229] = 24'h3618_00;
        rom[230] = 24'h3612_29;
        rom[231] = 24'h3709_52;
        rom[232] = 24'h370C_03;
        rom[233] = 24'h3A02_17;
        rom[234] = 24'h3A03_10;
        rom[235] = 24'h3A14_17;
        rom[236] = 24'h3A15_10;
        rom[237] = 24'h4004_02;
        rom[238] = 24'h4713_03;
        rom[239] = 24'h4407_04;
        rom[240] = 24'h460C_22;
        rom[241] = 24'h4837_22;
        rom[242] = 24'h3824_02;
        rom[243] = 24'h5001_A3;
        rom[244] = 24'h3B07_0A;
        rom[245] = 24'h503D_00;
        rom[246] = 24'h3016_02;
        rom[247] = 24'h301C_02;
        rom[248] = 24'h3019_02;
        rom[249] = 24'h3019_00;
    end

    assign tbl_data = rom[tbl_addr];

endmodule
