shenguangmu/complete_project_source/(commit log)

2026-09-16 初始提交：手势识别系统 PL 侧完整工程
    - rtl/ OV5640 SCCB 配置、DVP 采集、跨时钟域 FIFO
    - src_hls/ 手势预处理 HLS 核（灰度化/缩放/归一化）
    - vivado/ Block Design 自动化 Tcl 与 XDC 引脚约束
    - sw/ PS 侧预处理驱动与主机仿真
    - host/ PYNQ overlay 加载、golden 比对、叠加显示
    - sim/ 向量生成与比对脚本
    - docs/ 架构接口契约、复现指南、硬件采购清单
    [gesture_config.cfg]
2026-09-16 补 HDMI 端口的临时约束（方案 A）+ 实现验证结果
    本轮新增/修改：
    - vivado/constraints/video_io_hdmi_tmp.xdc 把 NSTD-1/UCIO-1 两条 DRC 降级，
    让比特流能生成（22 个 hdmi_vid_out_* 端口暂无引脚约束）
    - vivado/constraints/hdmi_drc_hook.tcl write_bitstream 的 pre-hook
    （在工程里直接 set_property SEVERITY 无效，run 是独立进程）
    - vivado/create_project.tcl 自动设置 pre-hook + 加入新约束
    - vivado/constraints/video_io.xdc 标注 HDMI 当前状态与方案 B 的收尾步骤
    - vivado/README.md 新增「HDMI 通路（方案 B）」章节
    + 完成实现验证结果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
2026-09-16 整理为可公开分享：路径去个人化 + 内置 legacy 参照工程
    为了让仓库可以被他人直接使用，做了三类清理：
    1. **内置原 Sobel 工程**（legacy/sobel/，18 个文件）
    本项目大量引用它作为参照（行缓存骨架的来源），但此前引用的是
    一个仓库外的本地路径，别人无从查看。现一并放入本仓库。
    + legacy/README.md 说明它是历史起点，并标注了那个值得看的
    驱动 D2 坑（状态位在 CTRL 而非 0x04）
    2. **路径去个人化**（26 处引用 + 若干本机路径）
    E:\project → legacy/sobel/
    C:\Users\<用户名>\... → 通用描述
    D:\BaiduNetdiskDo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
    [hls_config.cfg]
2026-09-16 更新各 README 到最新进度，清理外部依赖引用
    ## 状态同步（本轮进展）
    多个 README 还停在"cosim 未跑 / 实现未做"，已全部更新：
    - README.md 进度表补上 cosim 6/6 与 实现/时序/比特流/XSA
    一键回归加 cosim 命令（含缩小分辨率的提示）
    - vivado/README.md 顶部改为"只有一个 BD"（bd_sobel 已移入 legacy）
    约束文件表补上 HDMI 临时约束与 pre-hook
    - rtl/README.md iobuf_wrap 状态更新：功能仿真跑不了，但已过综合/实现
    - src_hls/README.md 进 BD 状态从"综合通过"更新为"综合+实现+比特流"
    - sw/README.md 新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
2026-09-17 同步 2026-09-17 批次修正 + 新增上板测试指南
    修复三处"工具全流程通过、只有上板才暴露"的静默故障：
    1. PS7 DDR 参数缺失 —— 原先 bd_video.tcl 一条 DDR 参数都没有，
    Vivado 静默套用出厂默认 MT41J128M8，而 PYNQ-Z2 板载是
    MT41K256M16。已补参数并加回读断言（写错就早失败）。
    2. 顶层被静默设成 dvp_capture —— BD 生成时会重建 wrapper，把
    make_wrapper 的产物从工程文件表挤掉，Vivado 只好在剩余模块里
    自动挑顶层，挑中了子模块。后果是整条 BD 未进综合，实现阶段报
    "67 out of 67 logical ports" 的 DRC。已加顶层回读断言 +
    wrapper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
    [ov5640_regs.v, tb_ov5640_regs.v]
2026-09-17 同步各 README 到最新状态
    上一轮只同步了 7 个文件，漏了各目录 README。本次全面核对后发现
    多处"占位表/未做/待写"的陈述已被实际进度推翻，且 vivado/README.md
    里的第 15 条结论是本轮实测推翻的：
    - 第 15 条曾写 [Netlist 29-160] "可忽略"。实际上它刷屏会掩盖真问题
    （PS7 DDR 参数错误当初就是被它盖住的），现已降级为 INFO。
    结论改为"产物无害，但要降噪"。
    - 新增坑 16-19（都是本次会话踩的，原先的 15 条都是 BD 构建期的）：
    16. 顶层被静默设成子模块 —— BD 重建 wrapper 时把它从工程文件表
    挤掉，Vivado 自动挑了 dvp_c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
2026-09-18 补充竞赛提交物：skill/ 技能包 + report/ 设计报告
    赛题 §3.3.5.5 的评测权重里，"大模型协作与技能包"占 15 分，
    且 §3.3.5.2 要求技能包置于 skill/ 目录、含 README 说明
    适用范围/使用方法/失效条件。此前项目完全没有这两项。
    skill/ —— 可复用技能包（换题目、换板卡仍可用）
    pynq/ 4 个独立 Python 工具，均不依赖本项目代码
    ip_contract 把 307KB 的 .hwh 压成 <3KB 契约
    gen_host_stub 一次生成 Python/C/测试三份代码
    golden_compare 逐位比对 + 生成优化对比表
    dma_guard DMA+cache 封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
2026-09-18 docs 文件名改为纯英文（赛题 §3.3.5.4 要求）
    赛题要求"仓库内所有目录名与文件名须使用纯英文（小写字母、数字、
    下划线或连字符），不得出现中文、空格或特殊字符，以保证跨平台
    复现与脚本自动化"。原 docs/ 下 4 个文档为中文名。
    重命名（用 git mv，保留历史）：
    架构与接口契约.md -> architecture-contract.md
    硬件采购清单.md -> hardware-checklist.md
    上板测试指南.md -> board-bringup-guide.md
    GUI复现指南_手势识别系统.md -> gui-reproduction-guide.md
    同时更新了 10 个文件里的 42 处引用（README、docs、report、
    skill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
2026-09-18 补综合与实现报告（赛题 §3.3.5.1 要求）
    赛题要求提交「综合与实现报告，含资源占用、时钟频率与关键性能指标」。
    - 恢复 vivado/gesture_system/utilization.rpt 入库。
    上一轮曾把它加进 .gitignore，理由是"纯报告、每次重新生成"——
    那是错的，它正是赛题要求的那份报告。
    入库前把报告头的本机信息（Host / 绝对路径）替换为占位符。
    - 新增 vivado/build-report.md：把三项要求汇总成一份可读摘要。
    原始 702KB 时序报告留在 .runs/（可重跑生成），本文只提炼关键指标。
    资源：LUT 11255 (21.16%) / FF 14810 (13.92%)
    DSP 61 (27.73%) / BR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
2026-09-18 写 design.md 正文（赛题 §3.3.5.3 的六节）
    按 report/README.md 里的骨架填完七节：
    ① 选题背景与创新点 —— 三个创新点，核心是"异构划分沿数据量×操作次数
    这条线切"，附可量化的否决理由（DSP 单层就吃掉 1/3、工期以月计、
    PS 侧 30ms/帧已够用，因为瓶颈在采集与预处理不在推理）
    ② 设计原理与功能框图 —— 两条数据通路（显示/CNN，从 DDR 分叉）+
    为什么不用 axis_broadcaster（ap_ctrl_hs 未启动时 tready=0，
    反压会把 HDMI 一起卡死）+ 时钟域表
    ③ 软硬件划分与接口 —— 五条判据的取舍表、唯一接口契约（96×96 uint8）、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
2026-09-18 尝试消 morph_stage 的 DSP —— 失败，已回退（保留记录）
    动因：morph_stage 占 56/71 个 DSP，其中腐蚀 pipeline 占 55 个，
    且实现日志里关键路径指向除法器/乘法器。想把它降下来，
    同时给只剩 +0.265 ns 的时序余量留空间。
    试了三种改法，实测结论：
    改法 DSP II 评价
    ─────────────────────────────────────────────
    原样（保留） 71 1 —
    width 改成模板常量 71 1 无效，省 0 个
    + 预计算行地址/手写边界分支 54 2 ✗ 吞吐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
2026-09-18 更正"DSP 来自 thresh_stage 整数除法"的错误论断（扩散到 4 个文件）
    实测（逐模块查 csynth.rpt）：
    morph_stage 56 <- 占全设计 79%
    crop_scale 4
    thresh_stage 2
    sobel_stage 1
    gaussian_stage 0
    原先四个文件都写着"DSP 偏高来自 thresh_stage 的整数除法"，
    而 thresh_stage 实际只占 2 个。这个错误论断扩散到了：
    src_hls/README.md（源头）
    docs/architecture-contract.md
    vivado/README.md（两处）
    report/design.md
    全部按实测更正，并记下教训：**DSP 归属要逐模块查表，
    不能凭"哪里有除法"推断**。
    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
2026-09-18 补 design.md 的学术引用（§1.4）
    三篇文献，**全部通过出版方页面或 DOI 核验过存在性**，
    未核验通过的不列入（MDPI 那篇抓不到正文，故未引）。
    ① IEICE Electronics Express 2024, Vol.21 No.4
    DOI: 10.1587/elex.21.20230579
    平台 PYNQ-Z2 + 场景手势识别 + ResNet-18，98.87% 精度 / 2.136 W
    → 与本作品同板同场景。它的功耗量级印证了本作品"CNN 放 PL 会
    顶到供电上限"的判断（本作品估 1.7 W，同量级）
    ② CANDAR 2020, pp.228-234
    DOI: 10.1109/CANDAR51075.2020.00039
    PYNQ-Z1 上 tiny YOLOv3，**相比同一块板的 PYNQ ARM CPU 加速 22×**
    → 它做的正是本作品 §4.4 待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
2026-09-18 整理待办清单 + 修正一处 WNS 不一致
    枚举全部 19 个 md 审计过时陈述（不按记忆挑 —— 上次就是因此漏了 7 个
    README）。发现并处理：
    1. docs/board-bringup-guide.md 的 WNS 还是 +1.177，而其余 4 个文件
    （README / vivado/README / build-report / design.md）都已是 +0.265。
    这是唯一的不一致，已更正并补上"逐次波动"的说明。
    2. report/README.md 重写。原"已知缺口"表已过时：
    - "缺学术引用" —— 已补 3 篇（均核验 DOI）
    - "DSP 优化（除改乘定点倒数）" —— 已试过并失败，那条建议是错的
    （DSP 大头在 morph_stage 不在 thresh_stage，且降 DSP 会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
2026-09-18 加 GitHub Actions：每次 push 自动跑 RTL 回归
    动因两条：
    1. `bash rtl/run_iverilog.sh`（3 个 TB）此前要**手动记得跑**，
    改了 RTL 忘了跑没人拦
    2. 赛题 §3.3.4 要求「保证工程可由他人从零复现」——
    每次 push 的自动回归记录是可复现性的直接证据
    只跑 RTL 那一个，不跑 `sw/build_preproc_sim.sh`：
    后者写死了找 Vitis 自带的 `clang.exe`（Windows 专有），Ubuntu runner
    上必然失败。它的三个 .c 本身没有 Windows 依赖（grep 确认过），
    只是脚本没做跨平台 fallback —— 要纳入 CI 得先给脚本加 `cc` 回退。
    跑一次 `run_iverilog.sh`，同时留完整日志 + 显式 g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
2026-09-18 build_preproc_sim.sh 支持非 Vitis 编译器，纳入 CI
    原脚本把 clang.exe 路径写死成 Windows 专有形式，在 Ubuntu runner 上
    必然失败，所以 sw 的主机自检一直进不了 CI。
    三个 .c 实测无 Windows 依赖（无 <windows.h> / _WIN32 / MS 专有调用，
    目标侧的 xil_* 头文件被 #ifdef PREPROC_SIM_BUILD 隔开），只是脚本
    没做跨平台 fallback。加一层探测：
    1) Vitis clang（VITIS_CLANG / XILINX_VITIS / 常见安装路径）—— 不变
    2) 退回 PATH 上的 cc / gcc / clang —— 新增
    3) 都没有时，说清该装什么，并打印正确用法
    Windows 本地行为一字未变（实测仍走第 1 条）。
    顺带修两处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
2026-09-18 查清 morph_stage 的 DSP 根因 + 纠正 WNS 归属（改的全是文档）
    起因是查 morph_stage 的 56 个 DSP 去了哪 —— 结果推翻了四处
    流传已久的说法。**代码一行没改**（gesture_preproc.cpp 只有注释差异）。
    ## DSP：连续推断错三次，最后靠探针定案
    1. "来自 thresh_stage 的整数除法" → thresh_stage 只占 2 个
    2. "来自 16 位常数魔数 21846" → 全文没有 21846
    3. "换成编译期步长能收窄位宽" → 实测毫无变化（71→71）
    4. "那就完全展开成 9 个标量读" → 实测反而更差（71→86）
    真实构成（查 Bind Op Report）：3 个 64x66→129 位乘法器，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
2026-09-18 按"B1 之后"的实际状态更新各文档的完成度表述
    上一轮只补了 optimization-report.md，但 report/README.md 与
    design.md 里还留着 B1 之前的旧措辞（"最薄的一节""只有单点数据"）。
    ## 完成度表述
    把"20 分项"拆成三块分别说，不再笼统地说"没有对比"：
    ✅ 资源/时序实测数据
    ✅ 优化尝试与结论（4 组对照实验 + 探针）
    ✅ 时序瓶颈定位
    ❌ 与基线的加速比 ← 唯一真缺口，须在 Cortex-A9 上测
    ## 回查原始会话后的两处如实修正
    用 grep 从会话记录里取出当时的原文，发现记录转述得比实际更绝对：
    1. 原文写的是"若干带 16 位常数魔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
    [gesture_preproc.cpp]
2026-09-18 继续更新各文档完成度，并修掉三处实质性错误
    ## 实质性错误（这一轮的主要收获）
    **① design.md §4.4 的延迟表漏了 crop_scale**
    原表合计写"~66,000 周期 / 0.66 ms"，但只加总了后五级。
    真实情况：
    crop_scale 2,073,634 周期 ← 占 97%
    其余五级合计 66,370 周期
    合计应为 **≈21.4 ms**，原表差了 **32 倍**。漏掉它的后果是
    会得出"整链 0.66 ms、还有优化空间"的结论，而实际 21.4 ms/帧
    ≈ 47 fps 才是这个 stage 的真实上限。
    根因很清楚：crop_scale 要逐像素读满整帧 640×480（LOOP_TRIPCOUNT
    480/1080 × 640/1920），而其余五级只跑 9,216 个像素。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
2026-09-19 板到前的准备：修一个静默 bug + 把上板验证脚本化
    板还有两天到。这轮做的是"板到那天能少踩坑"的事。
    ## 修掉一个静默 bug（本轮主要收获）
    host/gesture_overlay.py 里，有符号阈值偏置写成了 **8 位补码**：
    DEFAULT_THRESH_OFFSET = -8 & 0xFF # = 248
    p.write(REG_THRESH_OFFSET, thresh_offset & 0xFF)
    AXI-Lite 寄存器是 **32 位**，HLS 侧按 int 读。写 0x000000F8 进去，
    IP 读回来是 **+248** 而不是 -8 —— 阈值被抬到 255，**输出全黑**，
    而且 ap_done 照常置位、**不报任何错**。
    讽刺的是：
    - 那行注释写的是"有符号转补码" —— 思路对，位宽错
    - 同一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
2026-09-19 修 CI：离线自检不该依赖 numpy（CI 抓到的真问题）
    上一提交的 overlay-offline job 在本地过、在 CI 红：
    File "host/gesture_overlay.py", line 42, in <module>
    import numpy as np
    ModuleNotFoundError: No module named 'numpy'
    ## 值得记的是：这不是"CI 少了依赖"，是**模块的依赖划错了**
    `gesture_overlay.py` 里与硬件无关的那部分 —— `_as_i32()`、
    `check_config()`、寄存器与 DMA 偏移常量 —— **根本不碰数组**，是纯逻辑。
    把这些绑死在 numpy 上，等于让"不需要板子就能跑的自检"
    凭空多一个它并不使用的依赖。
    而且同一文件里 `pynq` 本来就是**软导入**的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
2026-09-19 上板指南 → 可打印的 Word 操作手册（由脚本生成，md 为准）
    ## 产出
    docs/上板测试操作手册.docx （61 KB，A4，约 20 页）
    **Markdown 是唯一事实来源，docx 是渲染产物。**
    改了 .md 重跑 `python scripts/build_manual.py` 即可 ——
    不让两份文档分叉（这个项目已在"双目录分叉"上吃过一次亏）。
    ## 针对"打印出来照着做"做的设计
    - A4 / 2cm 边距 / 正文 10.5pt；**每个二级标题另起一页**
    （手上拿一张纸做一个阶段）
    - 代码块等宽 + 灰底 + 左边框（终端命令抄错一个字符就白跑一轮）
    - 引用块左边框高亮（本手册的"⚠ 注意"全在引用块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
2026-09-19 手册：每段代码标「在哪跑」+ 串口工具选型（并修一个静默丢内容的 bug）
    ## 「在哪跑」标记
    上板最容易卡住的地方不是命令本身，而是**不知道该在哪儿敲**。
    手册里写一句 `python3 host/bringup_check.py`，人不该需要自己判断
    这行是在 **PC 上**跑还是在 **板上**跑 —— 猜错的报错是
    `ModuleNotFoundError` / `command not found`，看着像环境坏了，
    其实只是跑错了地方。
    - 加了 `【终端：...】` 标记语法：**纯文本里读起来也通顺**，
    所以同一份 .md 既能渲染成 Word，也能直接在编辑器里看
    - 渲染成带底色的徽标，按环境配色：
    PC 蓝 / PYNQ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
